Ryosuke-Kawamori/whiteboard-vplotter/examples/kawamori.py

from vplotter_motion import (
    setup,
    cleanup,
    move_to,
    MOTOR_SPACING,
)


FONT = {
    "カ": [
        (0.10, 0.25),
        (0.90, 0.25),
        (0.55, 0.25),
        (0.50, 0.50),
        (0.40, 0.72),
        (0.20, 0.95),
        (0.50, 0.50),
        (0.78, 0.92),
    ],

    "ワ": [
        (0.15, 0.22),
        (0.15, 0.48),
        (0.15, 0.25),
        (0.85, 0.25),
        (0.78, 0.50),
        (0.65, 0.72),
        (0.48, 0.86),
        (0.25, 0.96),
    ],

    "モ": [
        (0.18, 0.18),
        (0.82, 0.18),
        (0.50, 0.18),
        (0.50, 0.48),
        (0.15, 0.48),
        (0.85, 0.48),
        (0.50, 0.48),
        (0.50, 0.75),
        (0.55, 0.90),
        (0.75, 0.95),
        (0.88, 0.88),
    ],

    "リ": [
        (0.25, 0.18),
        (0.25, 0.65),
        (0.25, 0.38),
        (0.72, 0.18),
        (0.72, 0.58),
        (0.67, 0.72),
        (0.52, 0.85),
        (0.28, 0.96),
    ],

    "ョ": [
        (0.25, 0.35),
        (0.78, 0.35),
        (0.78, 0.58),
        (0.30, 0.58),
        (0.78, 0.58),
        (0.78, 0.85),
        (0.25, 0.85),
    ],

    "ウ": [
        (0.50, 0.10),
        (0.50, 0.24),
        (0.18, 0.24),
        (0.18, 0.48),
        (0.18, 0.28),
        (0.82, 0.28),
        (0.78, 0.50),
        (0.67, 0.72),
        (0.50, 0.86),
        (0.28, 0.96),
    ],

    "ス": [
        (0.18, 0.22),
        (0.82, 0.22),
        (0.72, 0.45),
        (0.58, 0.65),
        (0.38, 0.82),
        (0.18, 0.95),
        (0.58, 0.65),
        (0.78, 0.82),
        (0.90, 0.96),
    ],

    "ケ": [
        (0.38, 0.12),
        (0.33, 0.30),
        (0.23, 0.48),
        (0.10, 0.62),
        (0.23, 0.48),
        (0.88, 0.48),
        (0.60, 0.48),
        (0.58, 0.66),
        (0.50, 0.82),
        (0.32, 0.96),
    ],
}


def draw_char(char, x0, y0, width, height):
    for px, py in FONT[char]:
        tx = x0 + px * width
        ty = y0 + py * height

        move_to(tx, ty)


def draw_text(
    text,
    center_x,
    center_y,
    width=50.0,
    height=80.0,
    gap=12.0,
):
    total_width = (
        len(text) * width
        + (len(text) - 1) * gap
    )

    x0 = center_x - total_width / 2.0
    y0 = center_y - height / 2.0

    for char in text:
        print(f"Drawing: {char}")

        draw_char(
            char,
            x0,
            y0,
            width,
            height,
        )

        x0 += width + gap


if __name__ == "__main__":
    setup()

    try:
        draw_text(
            "カワモリリョウスケ",
            center_x=MOTOR_SPACING / 2.0,
            center_y=450.0,
            width=45.0,
            height=70.0,
            gap=10.0,
        )

        print("DONE: カワモリリョウスケ")

    finally:
        cleanup()
